jiricmi/logic_probe/typst_documentation/pic/hal-architecture.png

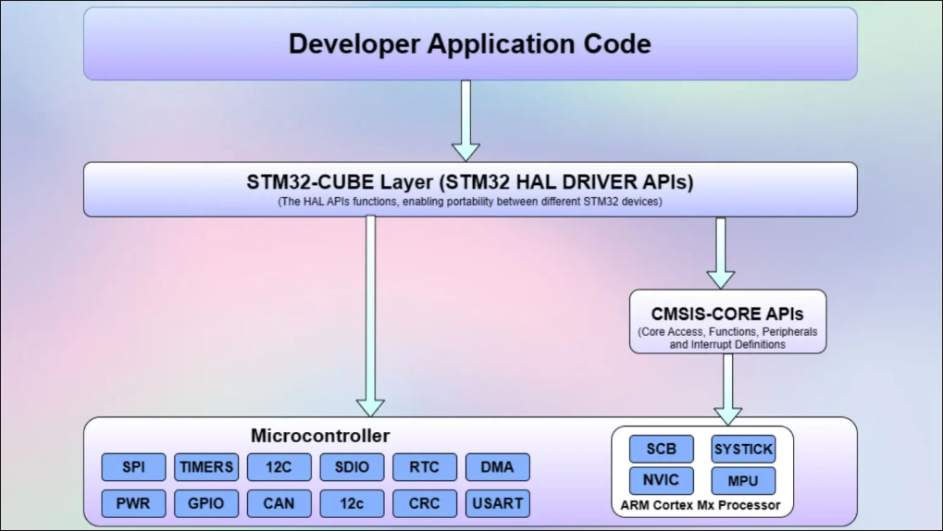
typst_documentation/pic/hal-architecture.png
