jiricmi/logic_probe/typst_documentation/pic/detector_freq.png

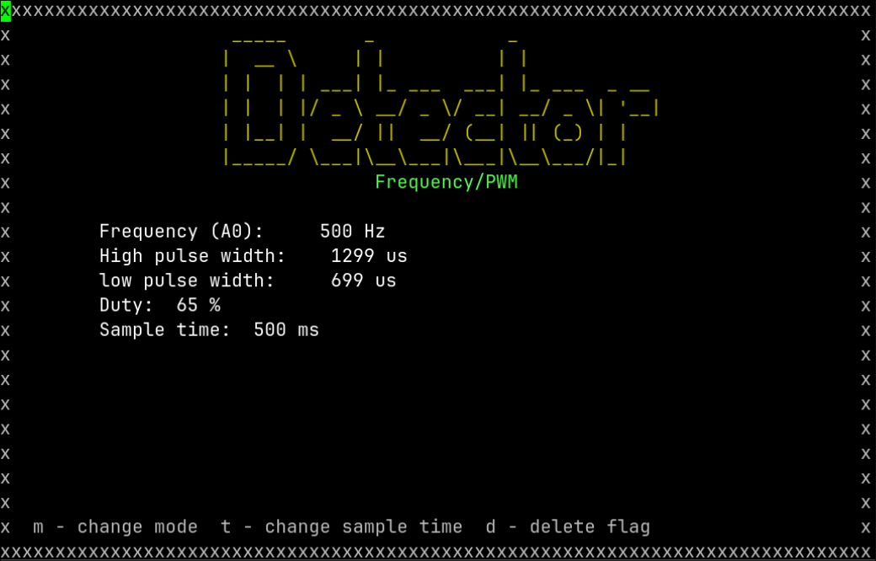
typst_documentation/pic/detector_freq.png
