jiricmi/logic_probe/typst_documentation/pic/option_bits.png

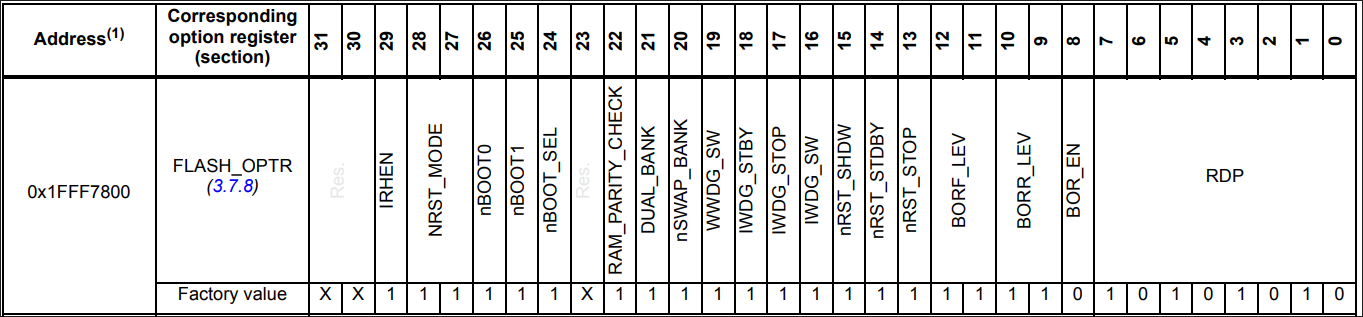
typst_documentation/pic/option_bits.png
