jiricmi/logic_probe/typst_documentation/pic/putty_settings.png

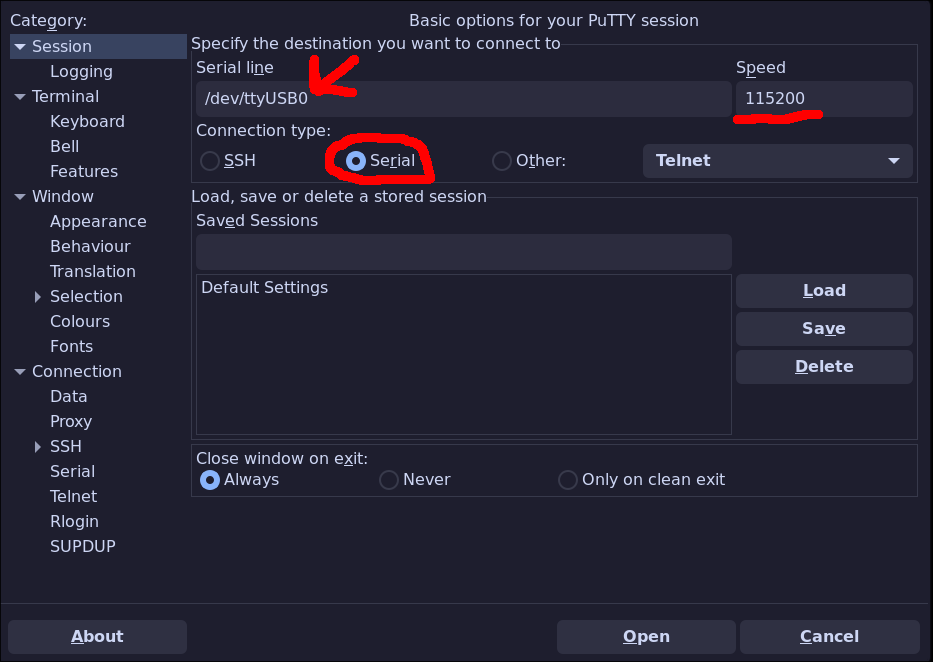
typst_documentation/pic/putty_settings.png
