jiricmi/logic_probe/typst_documentation/pic/neopixel_manual.png

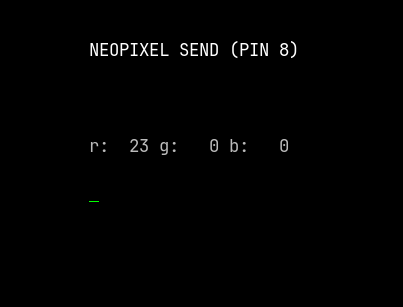
typst_documentation/pic/neopixel_manual.png
