jiricmi/logic_probe/typst_documentation/pic/ohmmeter_manual.png

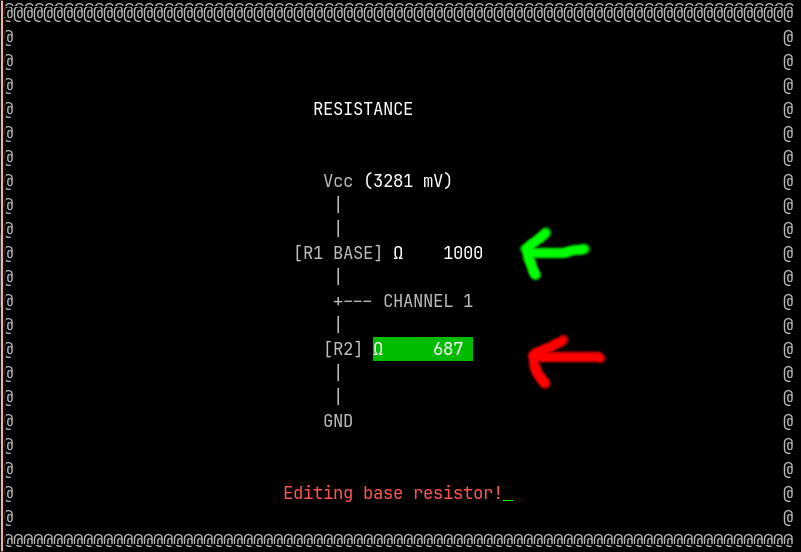
typst_documentation/pic/ohmmeter_manual.png
