jiricmi/logic_probe/logic_probe/Core/Src/main.c

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
/* Includes ------------------------------------------------------------------*/
#include "main.h"

/* USER CODE BEGIN Includes */
#include <stdbool.h>
#include "adc_control.h"
#include "ansi_pages.h"
#include "global_vars.h"
#include "loop.h"
#include "signal_detector.h"
#include "signal_generator.h"
#include "stm32g0xx_hal_tim.h"
#include "uart_control.h"
/* USER CODE END Includes */

ADC_HandleTypeDef hadc1;
DMA_HandleTypeDef hdma_adc1;

I2C_HandleTypeDef hi2c1;

TIM_HandleTypeDef htim1;
TIM_HandleTypeDef htim2;
TIM_HandleTypeDef htim3;
DMA_HandleTypeDef hdma_tim1_ch3;
DMA_HandleTypeDef hdma_tim2_ch1;
DMA_HandleTypeDef hdma_tim2_ch2;

UART_HandleTypeDef huart1;

/* USER CODE BEGIN PV */

sig_detector_t signal_detector;
sig_generator_t signal_generator;
neopixel_measure_t neopixel_measure;
shift_register_t shift_register;
visual_output_t visual_output;
button_data_t button_data;

global_vars_t global_var = {DEV_STATE_NONE,
                            LOCAL_STATE_LOGIC_PROBE,
                            LOCAL_SUBSTATE_CHANNEL_1,
                            DEV_SETUP_UART,
                            0,
                            true,
                            true,
                            ANSI_PAGE_MAIN,
                            NULL,
                            &signal_detector,
                            &signal_generator,
                            &visual_output,
                            &button_data,
                            &neopixel_measure,
                            &shift_register};

/* USER CODE END PV */

void SystemClock_Config(void);
static void MX_GPIO_Init(void);
static void MX_DMA_Init(void);
static void MX_ADC1_Init(void);
static void MX_TIM3_Init(void);
static void MX_TIM2_Init(void);
static void MX_USART1_UART_Init(void);
static void MX_TIM1_Init(void);
static void MX_I2C1_Init(void);
/**
 * @brief  The application entry point.
 * @retval int
 */
int main(void) {
    /* MCU
     * Configuration--------------------------------------------------------*/

    /* Reset of all peripherals, Initializes the Flash interface and the
     * Systick. */
    HAL_Init();

    /* Configure the system clock */
    SystemClock_Config();

    /* Initialize all configured peripherals */
    MX_GPIO_Init();
    MX_DMA_Init();
    MX_ADC1_Init();
    MX_TIM3_Init();
    MX_TIM2_Init();
    MX_USART1_UART_Init();
    MX_TIM1_Init();
    MX_I2C1_Init();
    /* USER CODE BEGIN 2 */
    HAL_ADCEx_Calibration_Start(&hadc1);
    HAL_UART_Receive_IT(&UART, &global_var.received_char, 1);

    adc_setup_channel_struct(global_var.adc_vars);
    init_detector(global_var.signal_detector, &htim2, &htim3);
    init_generator(global_var.signal_generator, &htim2);
    init_neopixel_measure(global_var.adv_neopixel_measure, &htim2);
    init_shift_register(global_var.adv_shift_register);
    init_visual_output(global_var.visual_output, &htim1);
    init_button_data(global_var.button_data);

    global_var.device_setup = dev_mode_get_dev_setup();
    if (global_var.device_setup == DEV_SETUP_LOCAL) {
        neopixel_startup_effect(global_var.visual_output);
    }
    /* USER CODE END 2 */

    /* Infinite loop */
    /* USER CODE BEGIN WHILE */
    while (1) {
        /* USER CODE END WHILE */

        /* USER CODE BEGIN 3 */
        if (global_var.device_setup == DEV_SETUP_UART) {
            dev_mode_run_with_uart();
        } else {
            dev_mode_run();
        }
    }
    /* USER CODE END 3 */
}

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
