jiricmi/logic_probe/logic_probe/logic_probe_dev.ioc

Mcu.UserName=STM32G031K8Tx
PA0.Signal=S_TIM2_CH1_ETR
PA13.Signal=GPXTI13
PA4.Signal=ADC1_IN4
PB6.Signal=S_TIM1_CH3
PB7.Signal=I2C1_SDA
PB8.Signal=I2C1_SCL
