jiricmi/logic_probe/logic_probe/Core/Src/perif/uart_control.c

#include "uart_control.h"
#include <stdbool.h>
#include "adc_control.h"
#include "ansi_abstraction_layer.h"
#include "ansi_page_voltage_measure.h"
#include "ansi_pages.h"
#include "global_vars.h"
#include "signal_detector.h"
#include "signal_generator.h"
#include "utils.h"

extern global_vars_t global_var;

void get_current_control(void) {
    switch (global_var.current_page) {
        case ANSI_PAGE_MAIN:
            control_main_page();
            break;
        case ANSI_PAGE_VOLTAGE_MEASURE:
            control_voltage_page();
            break;
        case ANSI_PAGE_FREQUENCY_READER:
            control_frequency_reader_page();
            break;
        case ANSI_PAGE_IMPULSE_GENERATOR:
            control_impulse_generator_page();
            break;

        default:
            control_main_page();
    }
}

void control_main_page(void) {
    switch (global_var.received_char) {
        case 'v':
        case 'V':
            ansi_clear_terminal();
            ansi_set_current_page(ANSI_PAGE_VOLTAGE_MEASURE);
            break;
        case 'f':
        case 'F':
            ansi_clear_terminal();
            ansi_set_current_page(ANSI_PAGE_FREQUENCY_READER);
            break;
        case 'g':
        case 'G':
            ansi_clear_terminal();
            ansi_set_current_page(ANSI_PAGE_IMPULSE_GENERATOR);
    }
}

void control_voltage_page(void) {
    switch (global_var.received_char) {
        case 'q':
        case 'Q':
            adc_remove_unapplied_channels(global_var.adc_vars);
            ansi_clear_terminal();
            ansi_set_current_page(ANSI_PAGE_MAIN);
            break;
        case '1':
        case '2':
        case '3':
        case '4': {
            int num = cdtoi(global_var.received_char);
            if (num == -1) {
                // TODO: handle error
            }
            adc_flip_unapplied_channel(global_var.adc_vars, (size_t)num);
            ansi_render_voltage_measures(global_var.adc_vars);
            break;
        }
        case 's':
        case 'S':
            adc_apply_channels(global_var.adc_vars);
            adc_setup_channel_struct(global_var.adc_vars);
            ansi_clear_terminal();
            ansi_render_current_page();
    }
}

void control_frequency_reader_page(void) {
    switch (global_var.received_char) {
        case 'q':
        case 'Q':
            ansi_clear_terminal();
            ansi_set_current_page(ANSI_PAGE_MAIN);
            break;
        case 'm':
        case 'M':
            detector_change_mode(global_var.signal_detector);
            break;
        case 't':
        case 'T':
            detector_change_sample_time(global_var.signal_detector);
            break;
        case 'd':
        case 'D':
            global_var.signal_detector->p = false;
            break;
    }
}

void control_impulse_generator_page(void) {
    switch (global_var.received_char) {
        case 'q':
        case 'Q':
            ansi_clear_terminal();
            ansi_set_current_page(ANSI_PAGE_MAIN);
            break;
        case 'a':
        case 'A':
            sig_gen_change_period(global_var.signal_generator, -1);
            break;
        case 's':
        case 'S':
            sig_gen_change_period(global_var.signal_generator, 1);
            break;
        case 'd':
        case 'D':
            sig_gen_change_period(global_var.signal_generator, -10);
            break;
        case 'f':
        case 'F':
            sig_gen_change_period(global_var.signal_generator, 10);
            break;
        case 'g':
        case 'G':
            sig_gen_change_period(global_var.signal_generator, -100);
            break;
        case 'h':
        case 'H':
            sig_gen_change_period(global_var.signal_generator, 100);
            break;
        case 'w':
        case 'W':
            sig_gen_toggle_pulse(global_var.signal_generator, false);
            break;
        case 't':
        case 'T':
            HAL_GPIO_TogglePin(GPIOA, GPIO_PIN_7);
            break;
        case 'y':
        case 'Y':
            sig_gen_toggle_pulse(global_var.signal_generator, true);
            break;
    }
}
