jiricmi/logic_probe/logic_probe/Core/Src/ansi/ansi_pages.c

#include "ansi_pages.h"

#include <stdbool.h>
#include "ansi_page_frequency_reader.h"
#include "ansi_page_impulse_generator.h"
#include "ansi_page_main.h"
#include "ansi_page_shift_register.h"
#include "ansi_page_voltage_measure.h"
#include "ansi_pages_neopixel_measure.h"
#include "global_vars.h"

extern global_vars_t global_var;

void ansi_render_current_page(void) {
    switch (global_var.current_page) {
        case ANSI_PAGE_MAIN:
        case ANSI_PAGE_MAIN_ADVANCED:
            ansi_render_main_page();
            break;
        case ANSI_PAGE_VOLTAGE_MEASURE:
            ansi_render_voltage_page();
            break;
        case ANSI_PAGE_FREQUENCY_READER:
            ansi_render_frequency_reader_page();
            break;
        case ANSI_PAGE_IMPULSE_GENERATOR:
            ansi_render_impulse_generator_page();
            break;
        case ANSI_PAGE_NEOPIXEL_MEASURE:
            ansi_render_neopixel_measure_page();
            break;
        case ANSI_PAGE_SHIFT_REGISTER:
            ansi_render_shift_register_page();
            break;
        default:
            ansi_render_main_page();
    }
}

void ansi_set_current_page(ansi_page_type_t page) {
    global_var.current_page = page;
}
