jiricmi/logic_probe/(commit log)

2024-11-08 create architecture for switching windows
2024-11-08 add voltage measuring
2024-11-08 add support of ansi printing measuring
2024-11-09 add applied to adc struct
2024-11-09 fix bug with broken startup terminal
    [main.c]
2024-11-11 adc rework of structure
    [adc_control.c, adc_control.h, ansi_pages.c, uart_control.c]
2024-11-11 measure voltage multiple channel
2024-11-11 dma support
2024-12-07 default first voltmeter channel activated
2024-12-07 add avg voltmeter and dynamic memory for dma
2024-12-08 add logic probe symbols
2025-03-03 add reset on error
    [main.c]
2025-03-13 add resistance measure
2025-03-20 add stm32flash
2025-03-21 add extern button
2025-03-27 disable voltagemeter on local mode
2025-04-04 add i2c
